Partamonni/K-ev/KiCad/BMS2_2/power_module/power_module.png

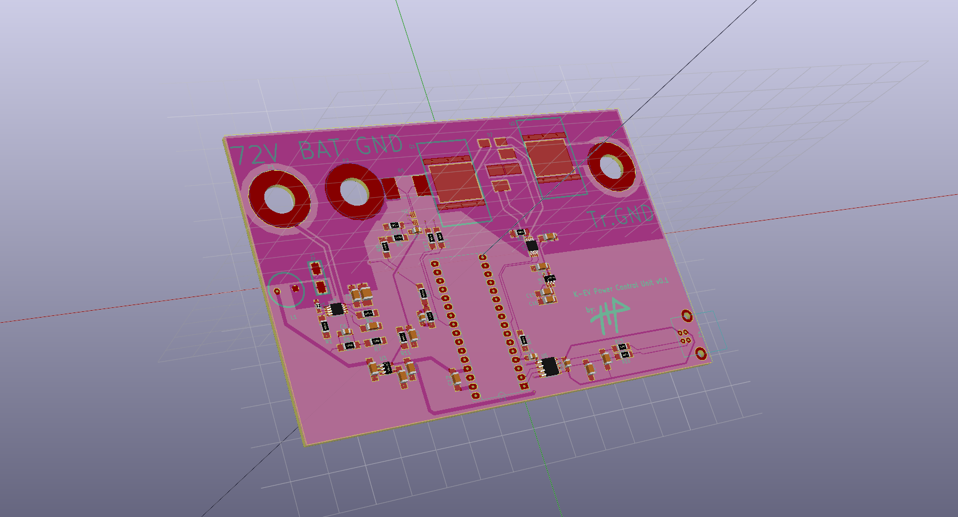
KiCad/BMS2_2/power_module/power_module.png
