Partamonni/K-ev/README.md

# K-ev
K-ev electric motorcycle repo

New, rewritten fork is available at https://github.com/Partamonni/K-ev3
