Partamonni/K-ev/entry.png

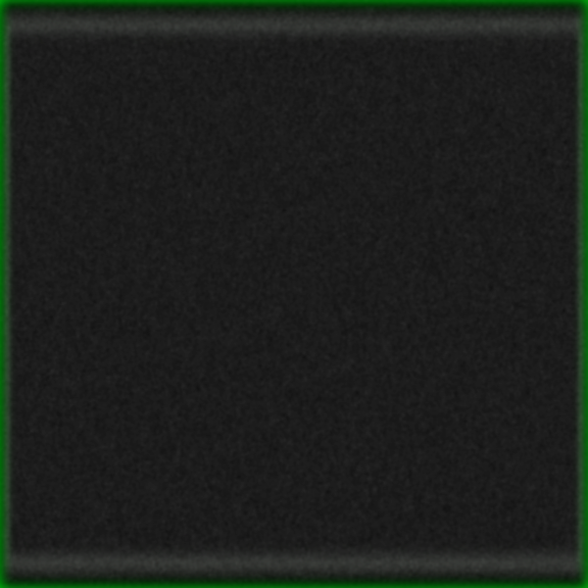
entry.png
