Partamonni/K-ev/K-EV_rev4.png

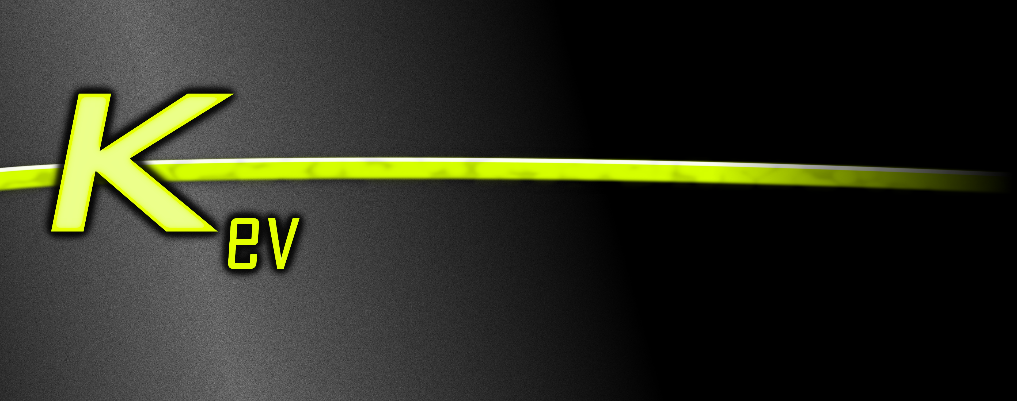
K-EV_rev4.png
