Partamonni/K-ev/KiCad/BMS2_2/power_module/pcu_v2.PNG

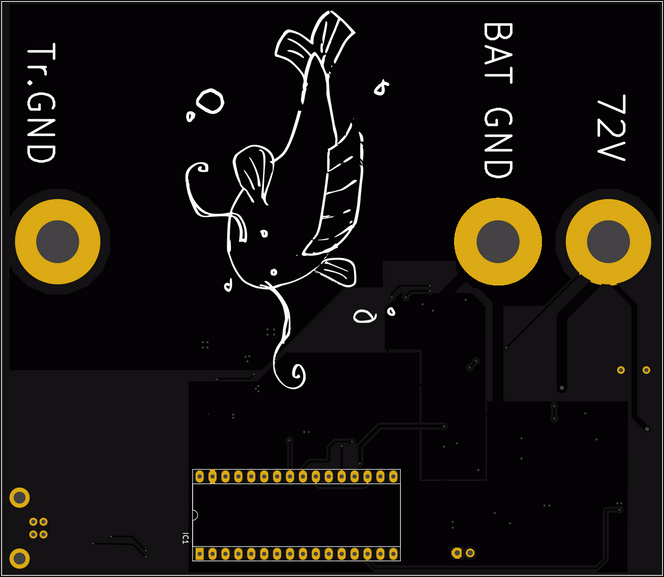
KiCad/BMS2_2/power_module/pcu_v2.PNG
