Partamonni/K-ev/KiCad/BMS2_2/power_module/pcu_v2_etu.PNG

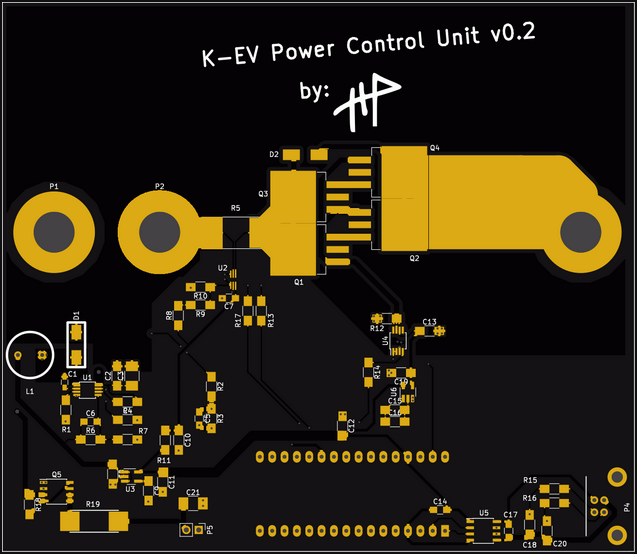
KiCad/BMS2_2/power_module/pcu_v2_etu.PNG
