Partamonni/K-ev/KiCad/BMS2_2/power_module/PCUv02.pdf

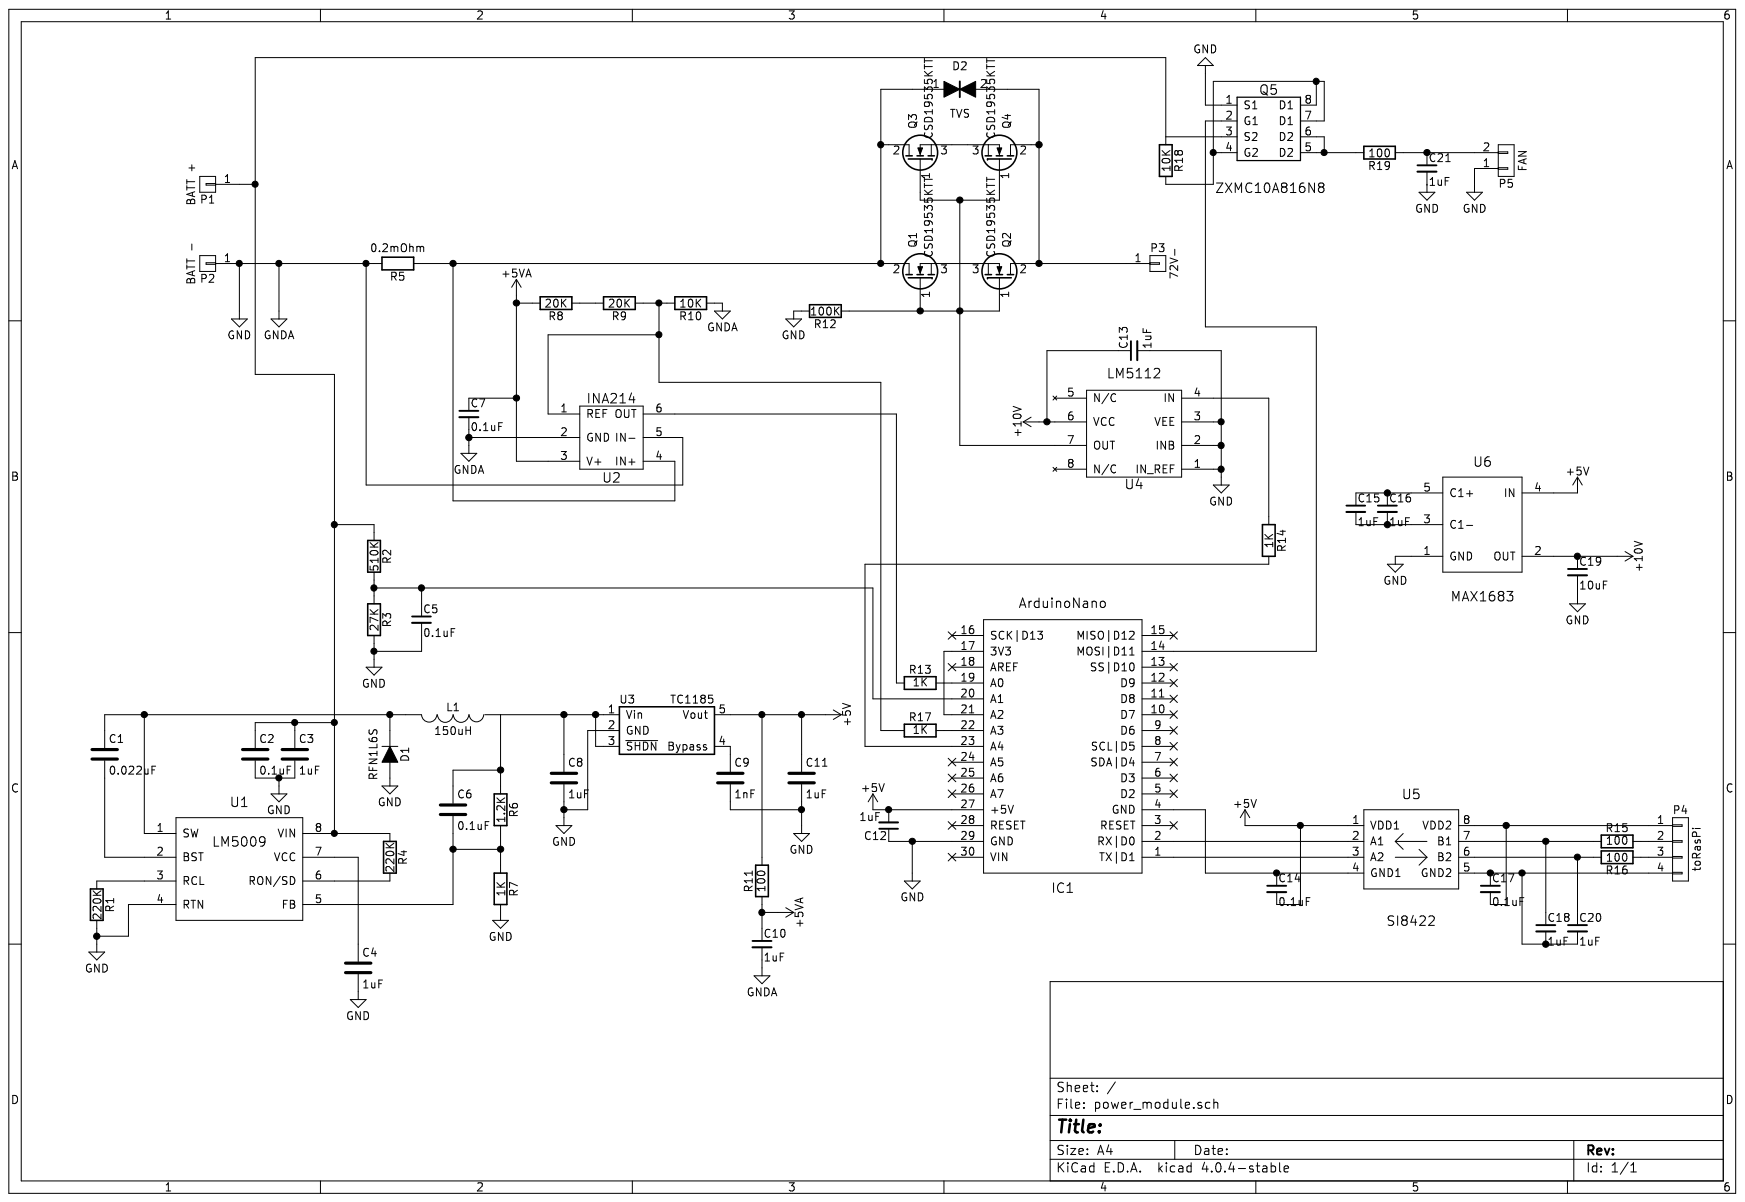
[picture p6: page 1]
