Partamonni/K-ev/KiCad/BMS2_2/power_module/power_module.kicad_pcb

## KiCad design KiCad/BMS2_2/power_module/power_module.kicad_pcb (2018-10-22)

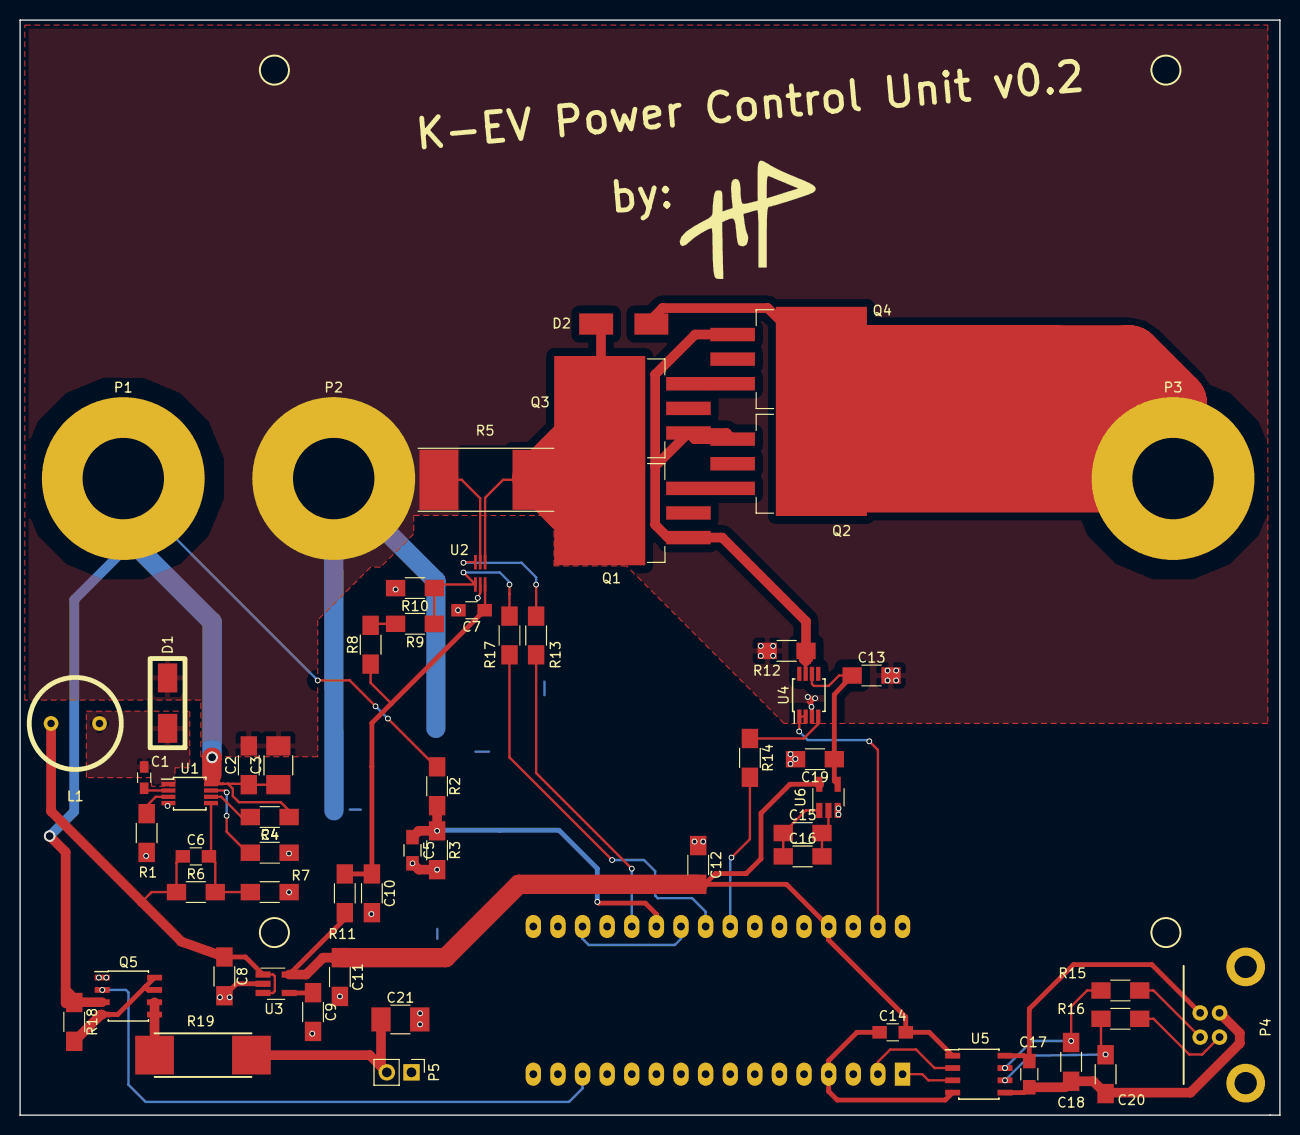
[picture p7: board power_module.kicad_pcb from above]

Board: 2 copper layers, 130.0 x 113.0 mm, 60 parts (1 on the bottom side), 42 nets.

Parts:
C1: 0.022uF; R_0603_HandSoldering
C2: 0.1uF; R_1206_HandSoldering
C3: 1uF; R_1210_HandSoldering
C4, C8, C10, C11, C12, C13, C15, C16, C18, C20: 1uF; R_1206_HandSoldering
C5, C6, C7, C14, C17: 0.1uF; R_0805_HandSoldering
C9: 1nF; R_1206_HandSoldering
C19: 10uF; R_1206_HandSoldering
C21: 1uF; C_1210_HandSoldering
D1: RFN1L6S; ROHM_RFN1L6S_HAND_SOLDER
D2: TVS; DO-214AA
IC1: ArduinoNano; DIP-32_W15.24mm_Socket_LongPads_Arduino_Nano
L1: 150uH; Bourns_RLB0914-151KL
P1: BATT +; MountingHole_8.4mm_M8_Pad
P2: BATT -; MountingHole_8.4mm_M8_Pad
P3: 72V-; MountingHole_8.4mm_M8_Pad
P4: toRasPi; USB_B_JACK
P5: FAN; Pin_Header_Straight_1x02_Pitch2.54mm
Q1, Q2, Q3, Q4: CSD19535KTT; TO-263-3Lead
Q5: ZXMC10A816N8; SOIC-8_3.9x4.9mm_Pitch1.27mm
R1, R4: 220K; R_1206_HandSoldering
R2: 510K; R_1206_HandSoldering
R3: 27K; R_1206_HandSoldering
R5: 0.2mOhm; Bourns_CSS2H-3920_200uOhm_hand_solder
R6: 1.2K; R_1206_HandSoldering
R7, R13, R14, R17: 1K; R_1206_HandSoldering
R8, R9: 20K; R_1206_HandSoldering
R10, R18: 10K; R_1206_HandSoldering
R11, R15, R16: 100; R_1206_HandSoldering
R12: 100K; R_1206_HandSoldering
R19: 100; TE_SMW_3
U1: LM5009; MSOP-8_3x3mm_Pitch0.65mm
U2: INA214; SC-70-6_Handsoldering
U3: TC1185; SOT-23-5_HandSoldering
U4: LM5112; MSOP-8_3x3mm_Pitch0.65mm
U5: SI8422; SOIC-8_3.9x4.9mm_Pitch1.27mm
U6: MAX1683; SOT-23-5_HandSoldering

Connections:
+5V: C11.1, C12.2, C14.2, IC1.27, R11.2, U3.5, U5.1, U6.4
+5VA: C7.1, C10.1, R8.1, R11.1, U2.3
+10V: C13.1, C19.1, U4.6, U6.2
GND: C2.2, C3.2, C4.2, C5.2, C7.2, C8.2, C9.2, C10.2, C11.2, C12.1, C13.2, C19.2, C21.2, D1.2, IC1.29, P2.1, P5.1, Q5.1, R1.2, R3.2, R5.2, R7.2, R10.2, R12.2, U1.4, U2.2, U2.5, U3.2, U4.1, U4.2, U4.3, U6.1
unnamed: C1.1, D1.1, L1.2, U1.1
unnamed: C1.2, U1.2
unnamed: C2.1, C3.1, P1.1, Q5.3, R2.1, R4.1, R18.1, U1.8
unnamed: C4.1, U1.7
unnamed: C5.1, IC1.20, R2.2, R3.1
unnamed: C6.1, C8.1, L1.1, R6.1, U3.1, U3.3
unnamed: C6.2, R6.2, R7.1, U1.5
unnamed: C9.1, U3.4
unnamed: C14.1, IC1.4, U5.4
unnamed: C15.1, C16.1, U6.5
unnamed: C15.2, C16.2, U6.3
unnamed: C17.1, C18.2, C20.2, P4.4, U5.5
unnamed: C17.2, P4.1, U5.8
unnamed: C18.1, R15.1, U5.7
unnamed: C20.1, R16.2, U5.6
unnamed: C21.1, P5.2, R19.1
unnamed: D2.1, Q1.2, Q3.2, R5.1, U2.4
unnamed: D2.2, P3.1, Q2.2, Q4.2
unnamed: IC1.1, U5.3
unnamed: IC1.2, U5.2
unnamed: IC1.14, Q5.2
unnamed: IC1.17, IC1.21
unnamed: IC1.19, R13.2
unnamed: IC1.22, R17.2
unnamed: IC1.23, R14.2
unnamed: P4.2, R15.2
unnamed: P4.3, R16.1
unnamed: Q1.1, Q2.1, Q3.1, Q4.1, R12.1, U4.7
unnamed: Q1.3, Q2.3
unnamed: Q3.3, Q4.3
unnamed: Q5.4, Q5.7, Q5.8, R18.2
unnamed: Q5.5, Q5.6, R19.2
unnamed: R1.1, U1.3
unnamed: R4.2, U1.6
unnamed: R8.2, R9.1
unnamed: R9.2, R10.1, R17.1, U2.1
unnamed: R13.1, U2.6
unnamed: R14.1, U4.4
