Partamonni/K-ev/KiCad/BMS2/Switch_matrix.sch

## KiCad design KiCad/BMS2/Switch_matrix.sch (2018-11-02)

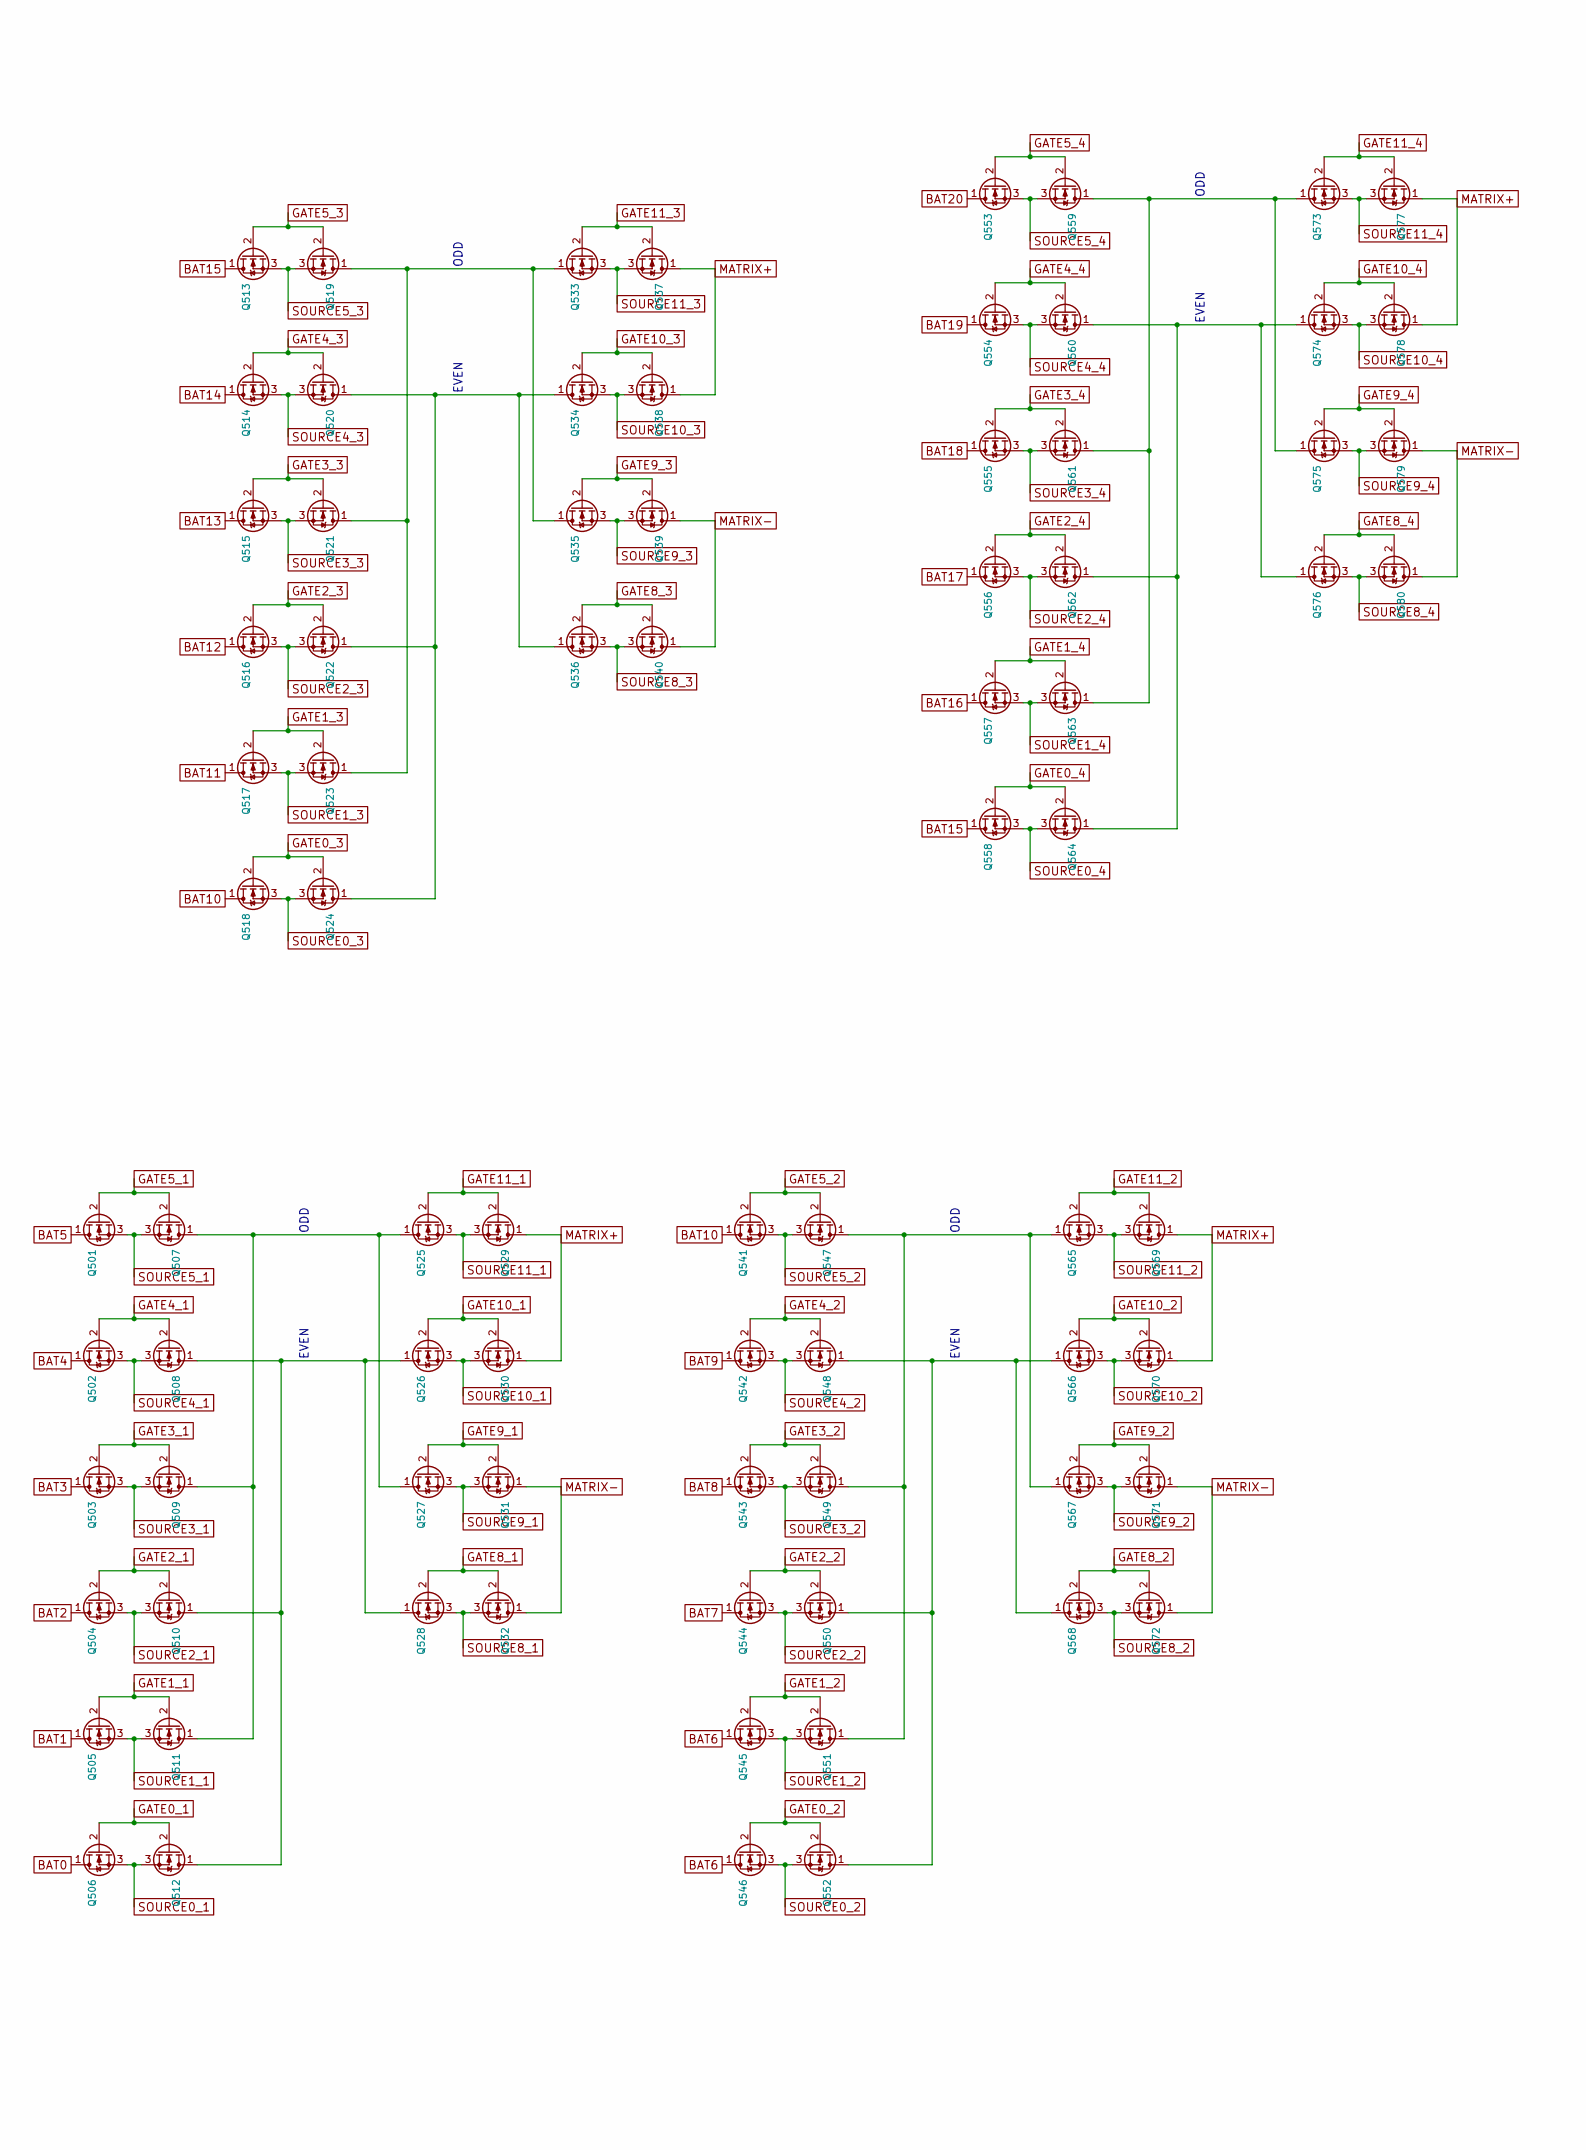
[picture p8: schematic Switch_matrix.sch, part in row 1, column 1]

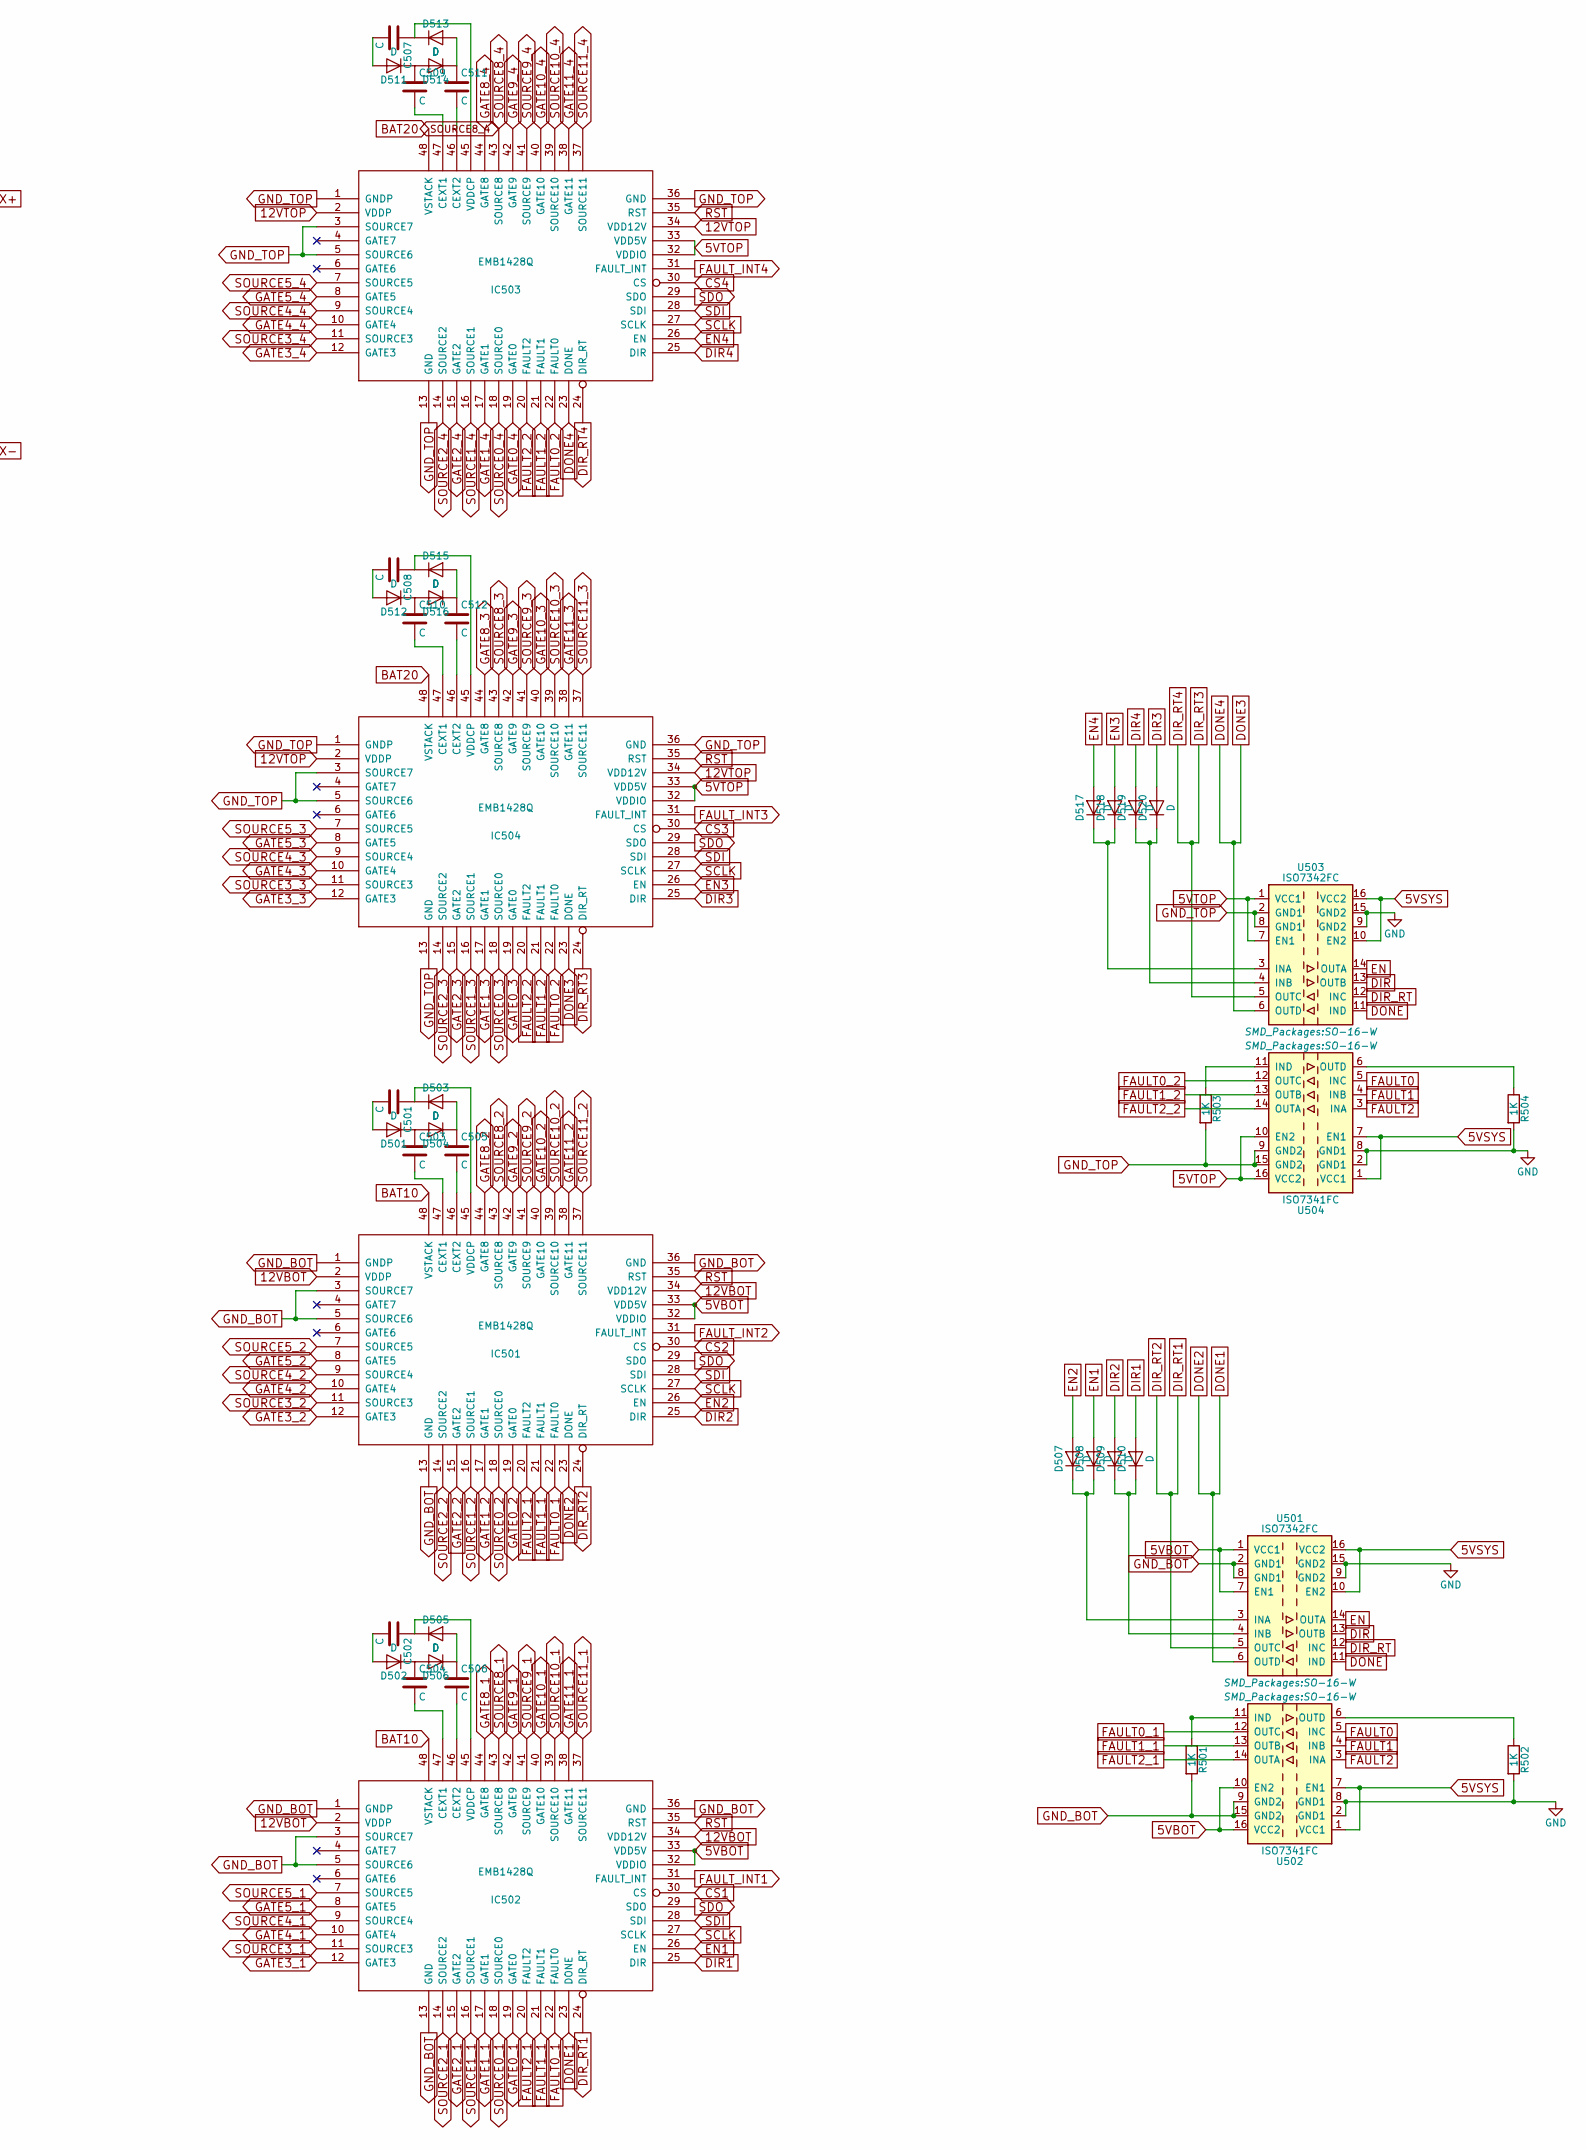
[picture p9: schematic Switch_matrix.sch, part in row 1, column 2]

Parts:
C501, C502, C503, C504, C505, C506, C507, C508, C509, C510, C511, C512: C
D501, D502, D503, D504, D505, D506, D507, D508, D509, D510, D511, D512, D513, D514, D515, D516, D517, D518, D519, D520: D
IC501, IC502, IC503, IC504: EMB1428Q; MODULE
Q501, Q502, Q503, Q504, Q505, Q506, Q507, Q508, Q509, Q510, Q511, Q512, Q513, Q514, Q515, Q516, Q517, Q518, Q519, Q520, Q521, Q522, Q523, Q524, Q525, Q526, Q527, Q528, Q529, Q530, Q531, Q532, Q533, Q534, Q535, Q536, Q537, Q538, Q539, Q540, Q541, Q542, Q543, Q544, Q545, Q546, Q547, Q548, Q549, Q550, Q551, Q552, Q553, Q554, Q555, Q556, Q557, Q558, Q559, Q560, Q561, Q562, Q563, Q564, Q565, Q566, Q567, Q568, Q569, Q570, Q571, Q572, Q573, Q574, Q575, Q576, Q577, Q578, Q579, Q580: Q_NMOS_DGS
R501, R502, R503, R504: 1K
U501, U503: ISO7342FC; SO-16-W
U502, U504: ISO7341FC; SO-16-W

Connections:
5VBOT: IC501.32 (VDDIO), IC501.33 (VDD5V), IC502.32 (VDDIO), IC502.33 (VDD5V), U501.1 (VCC1), U501.7 (EN1), U502.10 (EN2), U502.16 (VCC2)
5VSYS: U501.10 (EN2), U501.16 (VCC2), U502.1 (VCC1), U502.7 (EN1), U503.10 (EN2), U503.16 (VCC2), U504.1 (VCC1), U504.7 (EN1)
5VTOP: IC503.32 (VDDIO), IC503.33 (VDD5V), IC504.32 (VDDIO), IC504.33 (VDD5V), U503.1 (VCC1), U503.7 (EN1), U504.10 (EN2), U504.16 (VCC2)
12VBOT: IC501.2 (VDDP), IC501.34 (VDD12V), IC502.2 (VDDP), IC502.34 (VDD12V)
12VTOP: IC503.2 (VDDP), IC503.34 (VDD12V), IC504.2 (VDDP), IC504.34 (VDD12V)
BAT0: Q506.1 (D)
BAT1: Q505.1 (D)
BAT2: Q504.1 (D)
BAT3: Q503.1 (D)
BAT4: Q502.1 (D)
BAT5: Q501.1 (D)
BAT6: Q545.1 (D), Q546.1 (D)
BAT7: Q544.1 (D)
BAT8: Q543.1 (D)
BAT9: Q542.1 (D)
BAT10: IC501.48 (VSTACK), IC502.48 (VSTACK), Q518.1 (D), Q541.1 (D)
BAT11: Q517.1 (D)
BAT12: Q516.1 (D)
BAT13: Q515.1 (D)
BAT14: Q514.1 (D)
BAT15: Q513.1 (D), Q558.1 (D)
BAT16: Q557.1 (D)
BAT17: Q556.1 (D)
BAT18: Q555.1 (D)
BAT19: Q554.1 (D)
BAT20: IC503.48 (VSTACK), IC504.48 (VSTACK), Q553.1 (D)
CS1: IC502.30 (CS)
CS2: IC501.30 (CS)
CS3: IC504.30 (CS)
CS4: IC503.30 (CS)
DIR: U501.13 (OUTB), U503.13 (OUTB)
DIR1: D510.2 (A), IC502.25 (DIR)
DIR2: D509.2 (A), IC501.25 (DIR)
DIR3: D520.2 (A), IC504.25 (DIR)
DIR4: D519.2 (A), IC503.25 (DIR)
DIR_RT: U501.12 (INC), U503.12 (INC)
DIR_RT1: IC501.24 (DIR_RT), IC502.24 (DIR_RT), U501.5 (OUTC)
DIR_RT3: IC503.24 (DIR_RT), IC504.24 (DIR_RT), U503.5 (OUTC)
DONE: U501.11 (IND), U503.11 (IND)
DONE1: IC501.23 (DONE), IC502.23 (DONE), U501.6 (OUTD)
DONE3: IC503.23 (DONE), IC504.23 (DONE), U503.6 (OUTD)
EN: U501.14 (OUTA), U503.14 (OUTA)
EN1: D508.2 (A), IC502.26 (EN)
EN2: D507.2 (A), IC501.26 (EN)
EN3: D518.2 (A), IC504.26 (EN)
EN4: D517.2 (A), IC503.26 (EN)
FAULT0: U502.5 (INC), U504.5 (INC)
FAULT0_1: IC501.22 (FAULT0), IC502.22 (FAULT0), U502.12 (OUTC)
FAULT0_2: IC503.22 (FAULT0), IC504.22 (FAULT0), U504.12 (OUTC)
FAULT1: U502.4 (INB), U504.4 (INB)
FAULT1_1: IC501.21 (FAULT1), IC502.21 (FAULT1), U502.13 (OUTB)
FAULT1_2: IC503.21 (FAULT1), IC504.21 (FAULT1), U504.13 (OUTB)
FAULT2: U502.3 (INA), U504.3 (INA)
FAULT2_1: IC501.20 (FAULT2), IC502.20 (FAULT2), U502.14 (OUTA)
FAULT2_2: IC503.20 (FAULT2), IC504.20 (FAULT2), U504.14 (OUTA)
FAULT_INT1: IC502.31 (FAULT_INT)
FAULT_INT2: IC501.31 (FAULT_INT)
FAULT_INT3: IC504.31 (FAULT_INT)
FAULT_INT4: IC503.31 (FAULT_INT)
GATE0_1: IC502.19 (GATE0), Q506.2 (G), Q512.2 (G)
GATE0_2: IC501.19 (GATE0), Q546.2 (G), Q552.2 (G)
GATE0_3: IC504.19 (GATE0), Q518.2 (G), Q524.2 (G)
GATE0_4: IC503.19 (GATE0), Q558.2 (G), Q564.2 (G)
GATE1_1: IC502.17 (GATE1), Q505.2 (G), Q511.2 (G)
GATE1_2: IC501.17 (GATE1), Q545.2 (G), Q551.2 (G)
GATE1_3: IC504.17 (GATE1), Q517.2 (G), Q523.2 (G)
GATE1_4: IC503.17 (GATE1), Q557.2 (G), Q563.2 (G)
GATE2_1: IC502.15 (GATE2), Q504.2 (G), Q510.2 (G)
GATE2_2: IC501.15 (GATE2), Q544.2 (G), Q550.2 (G)
GATE2_3: IC504.15 (GATE2), Q516.2 (G), Q522.2 (G)
GATE2_4: IC503.15 (GATE2), Q556.2 (G), Q562.2 (G)
GATE3_1: IC502.12 (GATE3), Q503.2 (G), Q509.2 (G)
GATE3_2: IC501.12 (GATE3), Q543.2 (G), Q549.2 (G)
GATE3_3: IC504.12 (GATE3), Q515.2 (G), Q521.2 (G)
GATE3_4: IC503.12 (GATE3), Q555.2 (G), Q561.2 (G)
GATE4_1: IC502.10 (GATE4), Q502.2 (G), Q508.2 (G)
GATE4_2: IC501.10 (GATE4), Q542.2 (G), Q548.2 (G)
GATE4_3: IC504.10 (GATE4), Q514.2 (G), Q520.2 (G)
GATE4_4: IC503.10 (GATE4), Q554.2 (G), Q560.2 (G)
GATE5_1: IC502.8 (GATE5), Q501.2 (G), Q507.2 (G)
GATE5_2: IC501.8 (GATE5), Q541.2 (G), Q547.2 (G)
GATE5_3: IC504.8 (GATE5), Q513.2 (G), Q519.2 (G)
GATE5_4: IC503.8 (GATE5), Q553.2 (G), Q559.2 (G)
GATE8_1: IC502.44 (GATE8), Q528.2 (G), Q532.2 (G)
GATE8_2: IC501.44 (GATE8), Q568.2 (G), Q572.2 (G)
GATE8_3: IC504.44 (GATE8), Q536.2 (G), Q540.2 (G)
GATE8_4: IC503.44 (GATE8), Q576.2 (G), Q580.2 (G)
GATE9_1: IC502.42 (GATE9), Q527.2 (G), Q531.2 (G)
GATE9_2: IC501.42 (GATE9), Q567.2 (G), Q571.2 (G)
GATE9_3: IC504.42 (GATE9), Q535.2 (G), Q539.2 (G)
GATE9_4: IC503.42 (GATE9), Q575.2 (G), Q579.2 (G)
GATE10_1: IC502.40 (GATE10), Q526.2 (G), Q530.2 (G)
GATE10_2: IC501.40 (GATE10), Q566.2 (G), Q570.2 (G)
GATE10_3: IC504.40 (GATE10), Q534.2 (G), Q538.2 (G)
GATE10_4: IC503.40 (GATE10), Q574.2 (G), Q578.2 (G)
GATE11_1: IC502.38 (GATE11), Q525.2 (G), Q529.2 (G)
GATE11_2: IC501.38 (GATE11), Q565.2 (G), Q569.2 (G)
GATE11_3: IC504.38 (GATE11), Q533.2 (G), Q537.2 (G)
GATE11_4: IC503.38 (GATE11), Q573.2 (G), Q577.2 (G)
GND: R502.2, R504.2, U501.9 (GND2), U501.15 (GND2), U502.2 (GND1), U502.8 (GND1), U503.9 (GND2), U503.15 (GND2), U504.2 (GND1), U504.8 (GND1)
GND_BOT: IC501.1 (GNDP), IC501.3 (SOURCE7), IC501.5 (SOURCE6), IC501.13 (GND), IC501.36 (GND), IC502.1 (GNDP), IC502.3 (SOURCE7), IC502.5 (SOURCE6), IC502.13 (GND), IC502.36 (GND), R501.2, U501.2 (GND1), U501.8 (GND1), U502.9 (GND2), U502.15 (GND2)
GND_TOP: IC503.1 (GNDP), IC503.3 (SOURCE7), IC503.5 (SOURCE6), IC503.13 (GND), IC503.36 (GND), IC504.1 (GNDP), IC504.3 (SOURCE7), IC504.5 (SOURCE6), IC504.13 (GND), IC504.36 (GND), R503.2, U503.2 (GND1), U503.8 (GND1), U504.9 (GND2), U504.15 (GND2)
MATRIX+: Q529.1 (D), Q530.1 (D), Q537.1 (D), Q538.1 (D), Q569.1 (D), Q570.1 (D), Q577.1 (D), Q578.1 (D)
MATRIX-: Q531.1 (D), Q532.1 (D), Q539.1 (D), Q540.1 (D), Q571.1 (D), Q572.1 (D), Q579.1 (D), Q580.1 (D)
unnamed: C501.1, D503.1 (K), IC501.45 (VDDCP)
unnamed: C501.2, D501.2 (A)
unnamed: C502.1, D505.1 (K), IC502.45 (VDDCP)
unnamed: C502.2, D502.2 (A)
unnamed: C503.1, D501.1 (K), D504.2 (A)
unnamed: C503.2, IC501.47 (CEXT1)
unnamed: C504.1, D502.1 (K), D506.2 (A)
unnamed: C504.2, IC502.47 (CEXT1)
unnamed: C505.1, D503.2 (A), D504.1 (K)
unnamed: C505.2, IC501.46 (CEXT2)
unnamed: C506.1, D505.2 (A), D506.1 (K)
unnamed: C506.2, IC502.46 (CEXT2)
unnamed: C507.1, D513.1 (K), IC503.45 (VDDCP)
unnamed: C507.2, D511.2 (A)
unnamed: C508.1, D515.1 (K), IC504.45 (VDDCP)
unnamed: C508.2, D512.2 (A)
unnamed: C509.1, D511.1 (K), D514.2 (A)
unnamed: C509.2, IC503.47 (CEXT1)
unnamed: C510.1, D512.1 (K), D516.2 (A)
unnamed: C510.2, IC504.47 (CEXT1)
unnamed: C511.1, D513.2 (A), D514.1 (K)
unnamed: C511.2, IC503.46 (CEXT2)
unnamed: C512.1, D515.2 (A), D516.1 (K)
unnamed: C512.2, IC504.46 (CEXT2)
unnamed: D507.1 (K), D508.1 (K), U501.3 (INA)
unnamed: D509.1 (K), D510.1 (K), U501.4 (INB)
unnamed: D517.1 (K), D518.1 (K), U503.3 (INA)
unnamed: D519.1 (K), D520.1 (K), U503.4 (INB)
unnamed: Q507.1 (D), Q509.1 (D), Q511.1 (D), Q525.1 (D), Q527.1 (D)
unnamed: Q508.1 (D), Q510.1 (D), Q512.1 (D), Q526.1 (D), Q528.1 (D)
unnamed: Q519.1 (D), Q521.1 (D), Q523.1 (D), Q533.1 (D), Q535.1 (D)
unnamed: Q520.1 (D), Q522.1 (D), Q524.1 (D), Q534.1 (D), Q536.1 (D)
unnamed: Q547.1 (D), Q549.1 (D), Q551.1 (D), Q565.1 (D), Q567.1 (D)
unnamed: Q548.1 (D), Q550.1 (D), Q552.1 (D), Q566.1 (D), Q568.1 (D)
unnamed: Q559.1 (D), Q561.1 (D), Q563.1 (D), Q573.1 (D), Q575.1 (D)
unnamed: Q560.1 (D), Q562.1 (D), Q564.1 (D), Q574.1 (D), Q576.1 (D)
unnamed: R501.1, U502.11 (IND)
unnamed: R502.1, U502.6 (OUTD)
unnamed: R503.1, U504.11 (IND)
unnamed: R504.1, U504.6 (OUTD)
RST: IC501.35 (RST), IC502.35 (RST), IC503.35 (RST), IC504.35 (RST)
SCLK: IC501.27 (SCLK), IC502.27 (SCLK), IC503.27 (SCLK), IC504.27 (SCLK)
SDI: IC501.28 (SDI), IC502.28 (SDI), IC503.28 (SDI), IC504.28 (SDI)
SDO: IC501.29 (SDO), IC502.29 (SDO), IC503.29 (SDO), IC504.29 (SDO)
SOURCE0_1: IC502.18 (SOURCE0), Q506.3 (S), Q512.3 (S)
SOURCE0_2: IC501.18 (SOURCE0), Q546.3 (S), Q552.3 (S)
SOURCE0_3: IC504.18 (SOURCE0), Q518.3 (S), Q524.3 (S)
SOURCE0_4: IC503.18 (SOURCE0), Q558.3 (S), Q564.3 (S)
SOURCE1_1: IC502.16 (SOURCE1), Q505.3 (S), Q511.3 (S)
SOURCE1_2: IC501.16 (SOURCE1), Q545.3 (S), Q551.3 (S)
SOURCE1_3: IC504.16 (SOURCE1), Q517.3 (S), Q523.3 (S)
SOURCE1_4: IC503.16 (SOURCE1), Q557.3 (S), Q563.3 (S)
SOURCE2_1: IC502.14 (SOURCE2), Q504.3 (S), Q510.3 (S)
SOURCE2_2: IC501.14 (SOURCE2), Q544.3 (S), Q550.3 (S)
SOURCE2_3: IC504.14 (SOURCE2), Q516.3 (S), Q522.3 (S)
SOURCE2_4: IC503.14 (SOURCE2), Q556.3 (S), Q562.3 (S)
SOURCE3_1: IC502.11 (SOURCE3), Q503.3 (S), Q509.3 (S)
SOURCE3_2: IC501.11 (SOURCE3), Q543.3 (S), Q549.3 (S)
SOURCE3_3: IC504.11 (SOURCE3), Q515.3 (S), Q521.3 (S)
SOURCE3_4: IC503.11 (SOURCE3), Q555.3 (S), Q561.3 (S)
SOURCE4_1: IC502.9 (SOURCE4), Q502.3 (S), Q508.3 (S)
SOURCE4_2: IC501.9 (SOURCE4), Q542.3 (S), Q548.3 (S)
SOURCE4_3: IC504.9 (SOURCE4), Q514.3 (S), Q520.3 (S)
SOURCE4_4: IC503.9 (SOURCE4), Q554.3 (S), Q560.3 (S)
SOURCE5_1: IC502.7 (SOURCE5), Q501.3 (S), Q507.3 (S)
SOURCE5_2: IC501.7 (SOURCE5), Q541.3 (S), Q547.3 (S)
SOURCE5_3: IC504.7 (SOURCE5), Q513.3 (S), Q519.3 (S)
SOURCE5_4: IC503.7 (SOURCE5), Q553.3 (S), Q559.3 (S)
SOURCE8_1: IC502.43 (SOURCE8), Q528.3 (S), Q532.3 (S)
SOURCE8_2: IC501.43 (SOURCE8), Q568.3 (S), Q572.3 (S)
SOURCE8_3: IC504.43 (SOURCE8), Q536.3 (S), Q540.3 (S)
SOURCE8_4: IC503.43 (SOURCE8), Q576.3 (S), Q580.3 (S)
SOURCE9_1: IC502.41 (SOURCE9), Q527.3 (S), Q531.3 (S)
SOURCE9_2: IC501.41 (SOURCE9), Q567.3 (S), Q571.3 (S)
SOURCE9_3: IC504.41 (SOURCE9), Q535.3 (S), Q539.3 (S)
SOURCE9_4: IC503.41 (SOURCE9), Q575.3 (S), Q579.3 (S)
SOURCE10_1: IC502.39 (SOURCE10), Q526.3 (S), Q530.3 (S)
SOURCE10_2: IC501.39 (SOURCE10), Q566.3 (S), Q570.3 (S)
SOURCE10_3: IC504.39 (SOURCE10), Q534.3 (S), Q538.3 (S)
SOURCE10_4: IC503.39 (SOURCE10), Q574.3 (S), Q578.3 (S)
SOURCE11_1: IC502.37 (SOURCE11), Q525.3 (S), Q529.3 (S)
SOURCE11_2: IC501.37 (SOURCE11), Q565.3 (S), Q569.3 (S)
SOURCE11_3: IC504.37 (SOURCE11), Q533.3 (S), Q537.3 (S)
SOURCE11_4: IC503.37 (SOURCE11), Q573.3 (S), Q577.3 (S)

Notes on the sheet:
EVEN
ODD
