Partamonni/K-ev/KiCad/BMS2/file5886E790.sch

## KiCad design KiCad/BMS2/file5886E790.sch (2017-10-02)

Schematic: file5886E790.sch

Parts:
C13, C14: 15u
C15, C16: 0.01u
C17, C18, C22, C24: 1u
C19, C20: 0.1u
C21, C23: 1n
C25, C26, C31, C32: 4.7u
C27, C28, C35: 330n
C29, C30, C34, C36: 100n
C33, C37: 10u
D21, D22, D23, D24: D_Schottky
IC5, IC6: LM5018
P4: RSD-100D-12
R5, R6, R7, R8, R9, R10: 130k
R11, R12: 46.4k
R13, R16: 8.25k
R14, R17: 1k
R15, R18: 2k
T1, T2: 47u
U5, U6, U7: 7805
