Partamonni/K-ev/KiCad/BMS2/rescue-backup/DC-controller-2018-10-29-22-54-28.sch

## KiCad design KiCad/BMS2/rescue-backup/DC-controller-2018-10-29-22-54-28.sch (2017-10-02)

Schematic: DC-controller-2018-10-29-22-54-28.sch

Parts:
C301, C304: 100n
C302: 4.7u
C303, C306: 10u
C305: C
D301: 6.2V
D302, D303: 30V
D304, D306, D307, D309: D
D305: 0.5V
D308: 100V
IC301: UCC27511
IC302: EMB1499Q
L301: 6.8u
Q301, Q302, Q303: Q_NMOS_DGS
Q304: Q_PMOS_DGS
R301, R311: 10K
R302: 2K
R303, R312: 0.01
R304, R309: 5.1
R305, R308, R310: 100K
R306, R307: 10R
T301: PA3856.005NL
