Partamonni/K-ev/KiCad/BMS2/rescue-backup/Monitoring-2018-10-29-22-54-28.sch

## KiCad design KiCad/BMS2/rescue-backup/Monitoring-2018-10-29-22-54-28.sch (2017-10-02)

Schematic: Monitoring-2018-10-29-22-54-28.sch

Parts:
C401, C402: 4.7uF
C403, C406, C409, C410, C411, C412, C413, C414, C415, C416, C417, C418, C419, C420, C421, C422, C423, C424, C425, C426, C427, C428, C429, C430, C431, C432, C433, C434, C435, C436: 1uF
C404, C405, C407, C408: 10uF
C437, C438, C439: 0.1uF
D401, D402, D403, D404: D
R401, R402, R403, R404, R437, R438: 100
R405, R406, R407, R408, R411, R412: 10K
R409, R410: 1M
R413, R414, R415, R416, R417, R418, R419, R420, R421, R422, R423, R424, R425, R426, R427, R428, R429, R430, R431, R432, R433, R434, R435, R436: 1K
U401, U402: ISO1540
U403, U404: bg76930
