Partamonni/K-ev/KiCad/BMS2/rescue-backup/Power_conversion-2018-10-29-22-54-28.sch

## KiCad design KiCad/BMS2/rescue-backup/Power_conversion-2018-10-29-22-54-28.sch (2017-10-02)

Schematic: Power_conversion-2018-10-29-22-54-28.sch

Parts:
C201, C202: 15u
C203, C204: 0.01u
C205, C206, C210, C212: 1u
C207, C208: 0.1u
C209, C211: 1n
C213, C214, C219, C220: 4.7u
C215, C216, C223: 330n
C217, C218, C222, C224: 100n
C221, C225: 10u
D201, D202, D203, D204: D_Schottky
IC201, IC202: LM5018
P201: RSD-100D-12
R201, R202, R203, R204, R205, R206: 130k
R207, R208: 46.4k
R209, R212: 8.25k
R210, R213: 1k
R211, R214: 2k
T201, T202: 47u
U201, U202, U203: 7805
