Partamonni/K-ev/KiCad/BMS2/rescue-backup/bms-2018-10-29-22-54-28.sch

## KiCad design KiCad/BMS2/rescue-backup/bms-2018-10-29-22-54-28.sch (2017-10-02)

Schematic: bms-2018-10-29-22-54-28.sch

Parts:
D101, D102, D103, D104: D
P101: Molex_conn

Notes on the sheet:
Power supplies
Balancing DC-control
Monitoring
Switch Matrix
