Partamonni/K-ev/(commit log)

2017-09-28 Revert "test2"
    This reverts commit 11873fafb9620dfb3f41b3c2ff70722c8dd9cfc9.
    [ampmeter.h]
2017-10-02 Schematics uploads for power control unit
    [DC-controller.sch, Monitoring.sch, Power_conversion.sch, Switch_matrix.sch, Traction system voltage converters.sch, _saved_file589CB899.sch, bms.kicad_pcb, bms.sch]
2017-10-03 Arduino code upload
    Also added one junction in schemas
    [power_module.sch]
2017-10-05 Added direct pin manipulation
    Also, STrated
2017-10-05 Revert "Slight fuck up with this git"
    This reverts commit c466bf0ab85ec2846da82903cb7f0dc0e604bdf4.
    [Power_module.ino]
2017-10-17 oh uh
    For arduino: MAX31820 temperature monitoring
    For Raspberry: lgpl entry
2017-10-17 Temperature readings
    Continued work with the implement
2017-10-22 Lots of stuff
    - #Defines didn't work, back to const int
    - Onewire declaration must be global
    - Wrote tempAdr table
    - deleted two unused variables and added criticalTFailure
    - changed all bitwise operations to neater forms
    - added a trap for setup cycle if ds.reset finds failure on com-line
    - added temperature trap for programs secondary loop
    - added a few responds towards host
    - changed static numbers (sensor count) to a global constant
    - did the conversion function to convert raw data to temperature reading
    [Power_module.ino]
2017-10-24 First working version
    - Added configuring script and modified head comment accordingly
    - Changed DEBUG back to to #define -version, also added VERBOSE tag along with DEBUG
    - Address table formatted with full zeroes
    - wdt_disable() added to prevent still occurred wdt reset loop
    - Added a lot of debug code to be outputted to serial
    - Adress validity check fixed, checks crc byte now
    - Most annoying data bug, wrong temp byte order now corrected
    - Overtemperature now shuts power
    [Power_module.ino]
2017-11-20 Revert "Slight adjustments"
    This reverts commit 7b9bba6fb82006954818c30b39243f595e4735de.
    [Power_module.ino]
2017-12-01 Revert "asd"
    This reverts commit 4e9a0a506c0f58515d602d51b063e07c4e7a7c9e.
    [mainwindow.h]
2018-02-07 Amperage has some serial work to do
    Working, continued to implement some serial analyzing.
    (Note to self: parent pointer doesn't work in class functions, must create m_parent pointer within class to access parent within class functions.)
    [ampmeter.cpp, mainwindow.cpp, mainwindow.h, otherentry.cpp, serialportreader.cpp, serialportreader.h]
2018-02-09 Fixed motion bug, all destinations are noww hard coded
    [mainwindow.cpp, serialportreader.cpp, serialportreader.h, tempentry.cpp, tempentry.h]
2018-09-11 Kicad and button pin change
    [power_module-2018-09-10-16-04-40.sch, power_module-2018-09-10-16-10-36.sch]
2018-09-11 Revert "delay"
    This reverts commit 2a76ca7d03e3e0bc33578b970b199577c49e2c8e.
    [mainwindow.h]
2018-09-11 Revert "trigger"
    This reverts commit 1e6bff870b3f3ccacaf5de3ed2d35f567c77fe88.
    [buttons.cpp]
2018-09-12 Simplifying code to see if it fixes anything
    [buttons.cpp]
2018-10-22 kicad + arduino
    [12vstepdown.kicad_pcb, 12vstepdown.sch, power_module-2018-09-17-15-33-24.sch, power_module.kicad_pcb, power_module.sch]
2018-11-02 Added slides for all entries
    All entries are now derived from Entry -class
    [DC-controller-2018-10-29-22-54-28.sch, Monitoring-2018-10-29-22-54-28.sch, Power_conversion-2018-10-29-22-54-28.sch, Switch_matrix-2018-10-29-22-54-28.sch, Switch_matrix.sch, bms-2018-10-29-22-54-28.sch]
2018-11-03 Fine tuning entry mechanisms
    Now repeated entry toggles doesn't leave entry open when dropdown->entryOpen != true, also motor toggles doesn't slide previous entry away.
    [Power_module1_3.ino, mainwindow.cpp]
2018-11-03 Update Arduino code/Power_module1_3/Power_module1_3.ino
    Started soc work, simplified current and voltage calculations. (Current calculation was even wrong before this)
    [Power_module1_3.ino]
2018-11-20 Power module improved, KiCad updates
    [bms-2018-11-13-21-20-20.sch, file5886E790-2018-11-13-21-20-20.sch]
